aalonsopuig/phasors_analyzer/images/20260515_142357.jpg

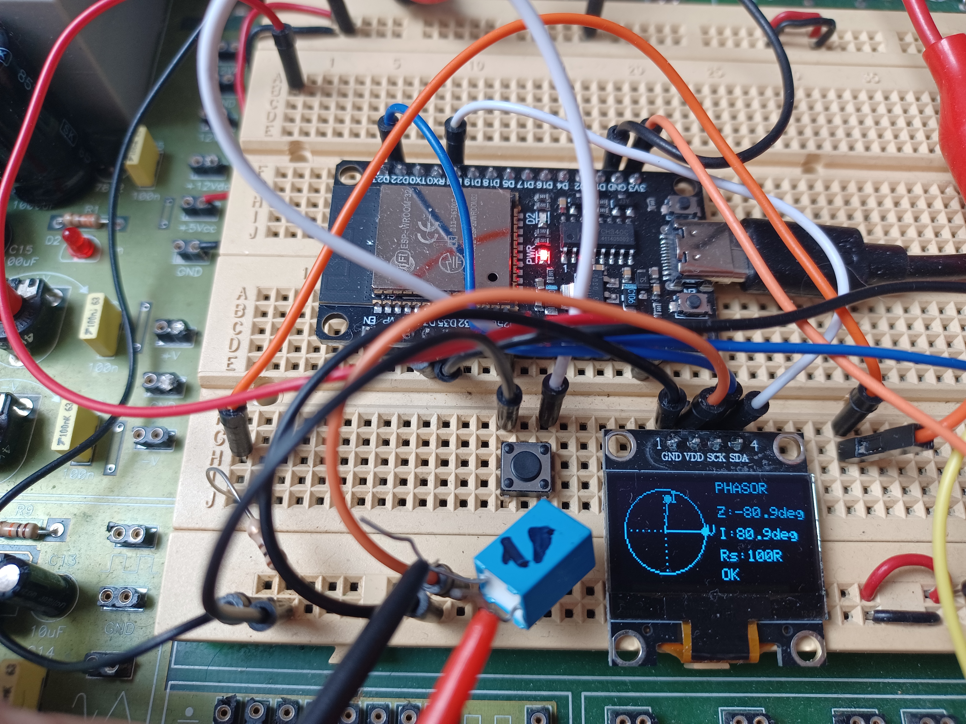
images/20260515_142357.jpg
