aalonsopuig/phasors_analyzer/images/phasor_L.jpg

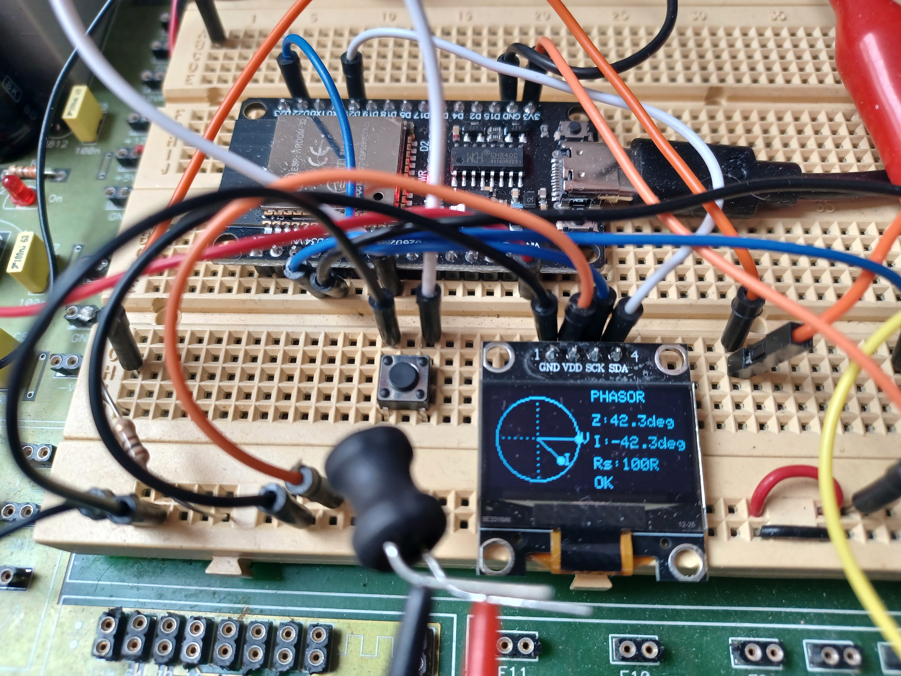
images/phasor_L.jpg
